mybesttools/Rowing_Display/assets/background-option-2.jpeg

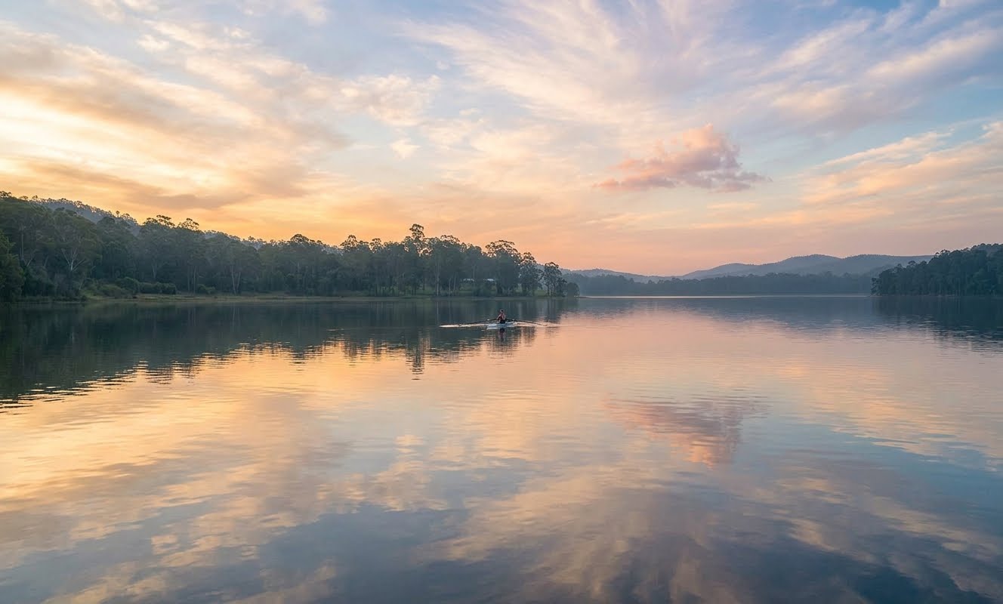
assets/background-option-2.jpeg
