mybesttools/Rowing_Display/assets/background-option-3.jpeg

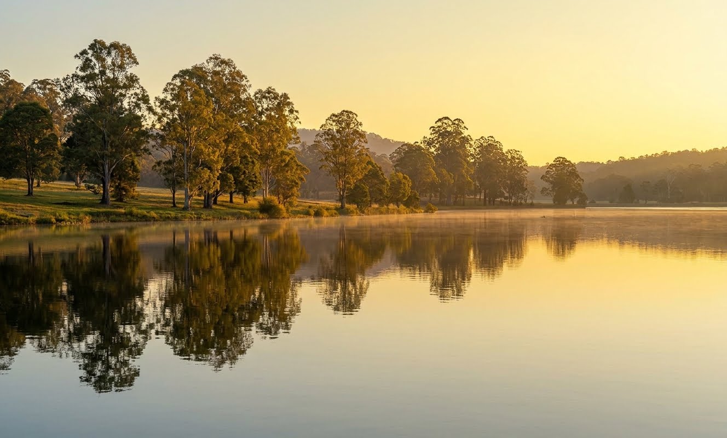
assets/background-option-3.jpeg
