mybesttools/Rowing_Display/assets/background-option-4.jpeg

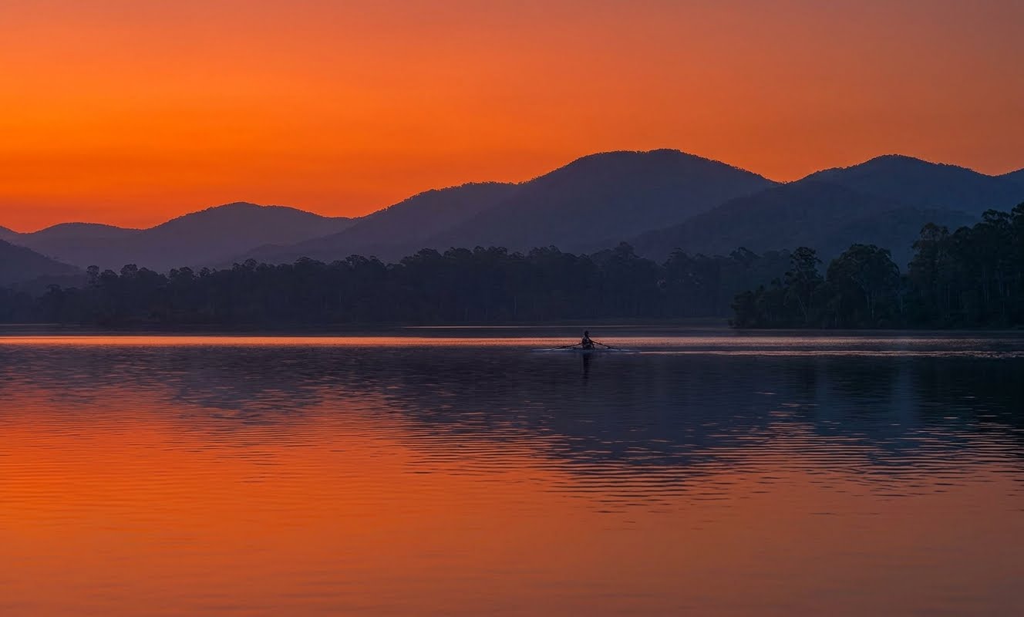
assets/background-option-4.jpeg
