mybesttools/Rowing_Display/assets/background-option-5.jpeg

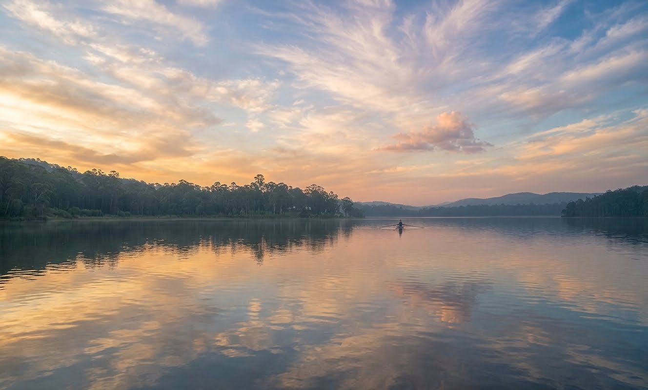
assets/background-option-5.jpeg
