mybesttools/Rowing_Display/assets/background-option-6.jpeg

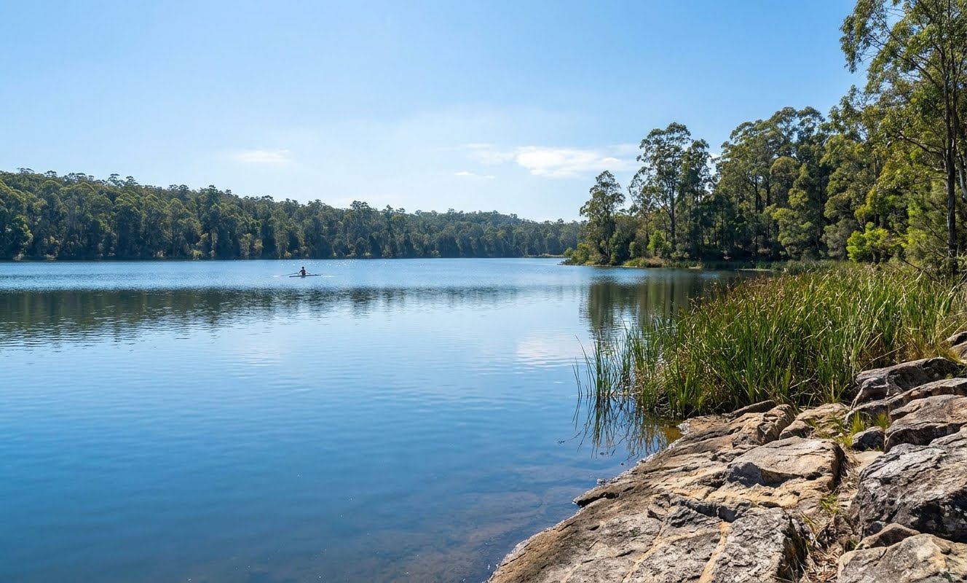
assets/background-option-6.jpeg
