mybesttools/Rowing_Display/assets/background-option-7.jpeg

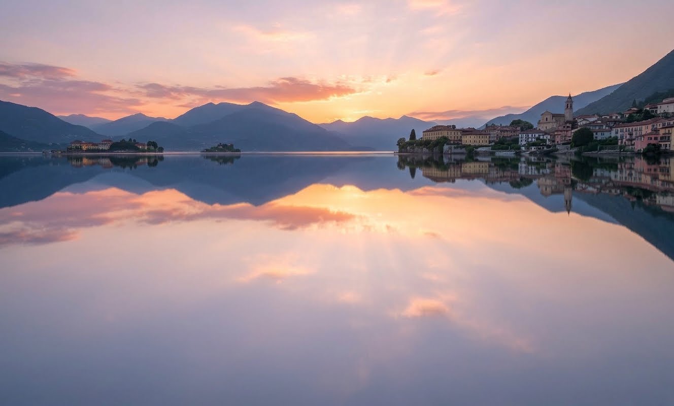
assets/background-option-7.jpeg
