mybesttools/Rowing_Display/assets/background-option-8.jpeg

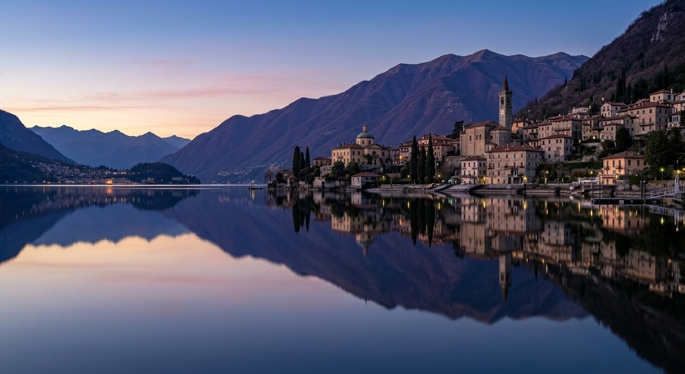
assets/background-option-8.jpeg
