mybesttools/Rowing_Display/assets/esp32-s3-touch-lcd-5-4_2.jpg

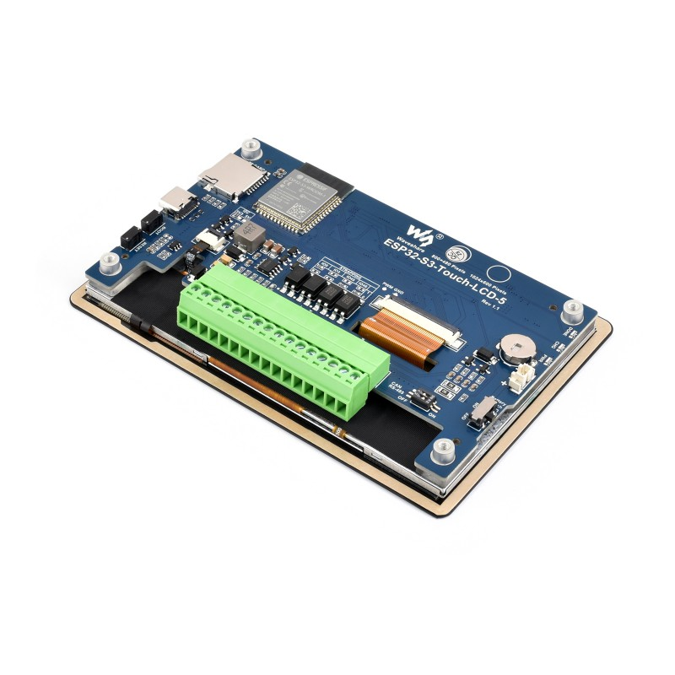
assets/esp32-s3-touch-lcd-5-4_2.jpg
