mybesttools/Rowing_Display/assets/scene_background.jpg

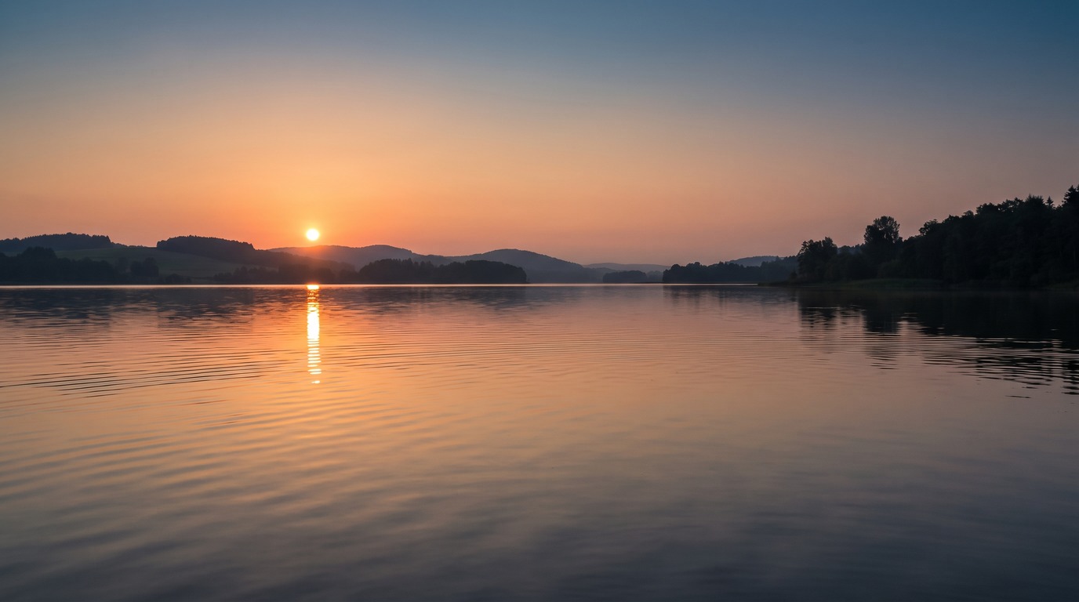
assets/scene_background.jpg
