mybesttools/Rowing_Display/docs/5-inch-device-display.jpeg

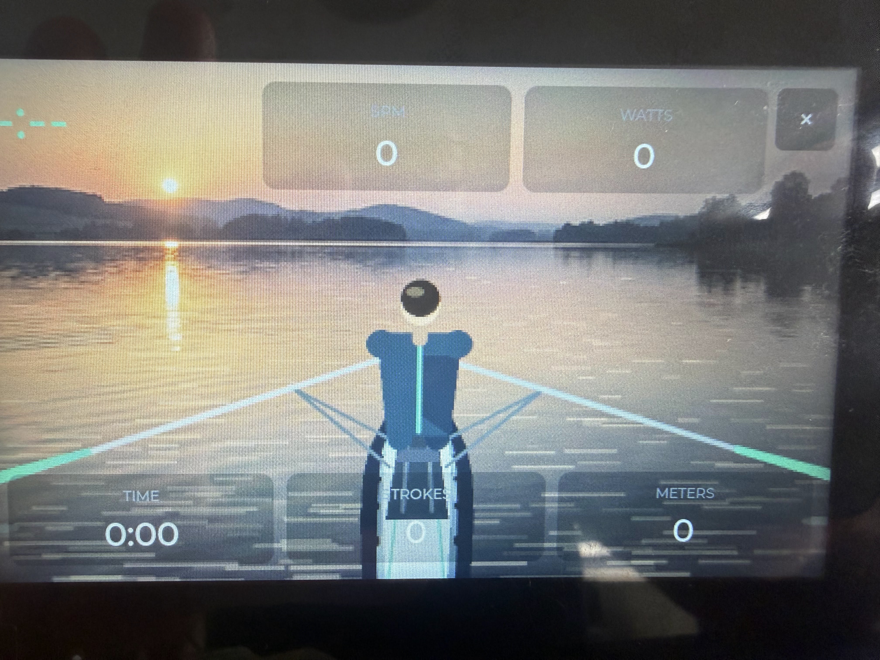
docs/5-inch-device-display.jpeg
