mybesttools/Rowing_Display/docs/blog/higgsfield-background/candidate-c-flux-2.jpg

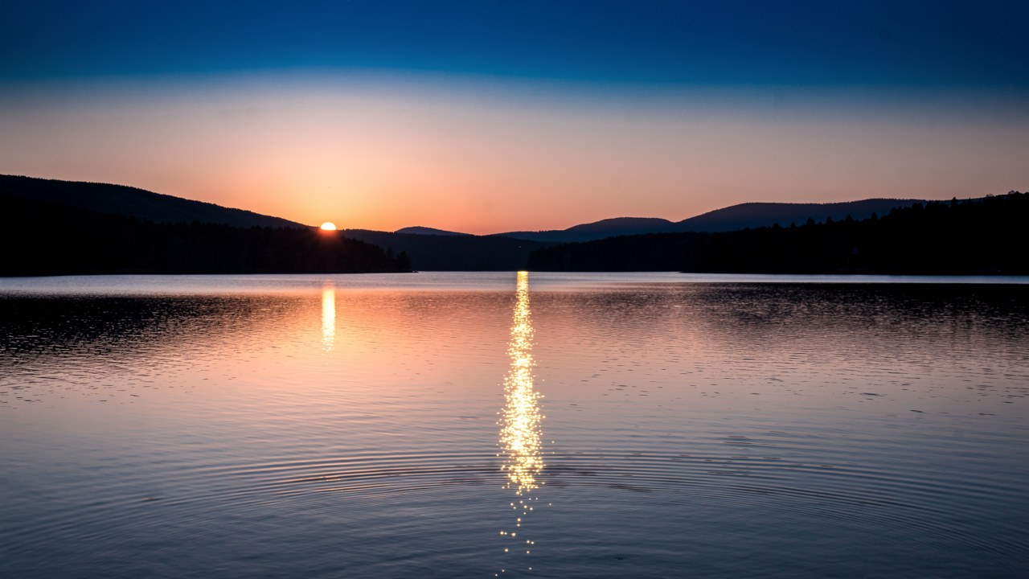
docs/blog/higgsfield-background/candidate-c-flux-2.jpg
