mybesttools/Rowing_Display/docs/blog/higgsfield-background/candidates-on-panel.png

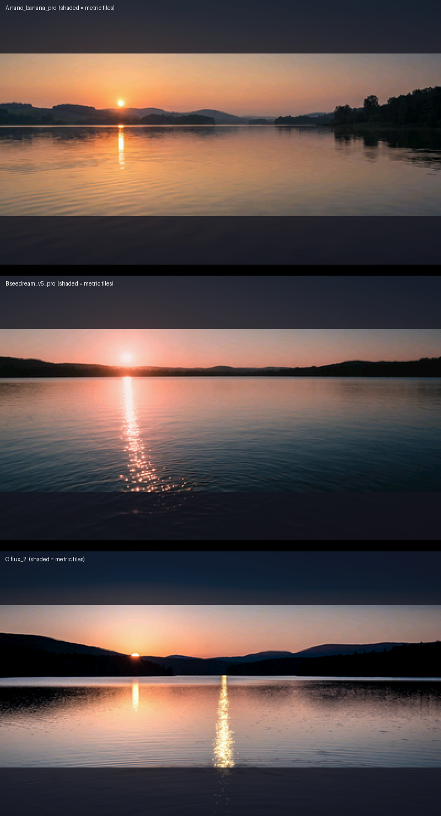
docs/blog/higgsfield-background/candidates-on-panel.png
