mybesttools/Rowing_Display/docs/board.jpg

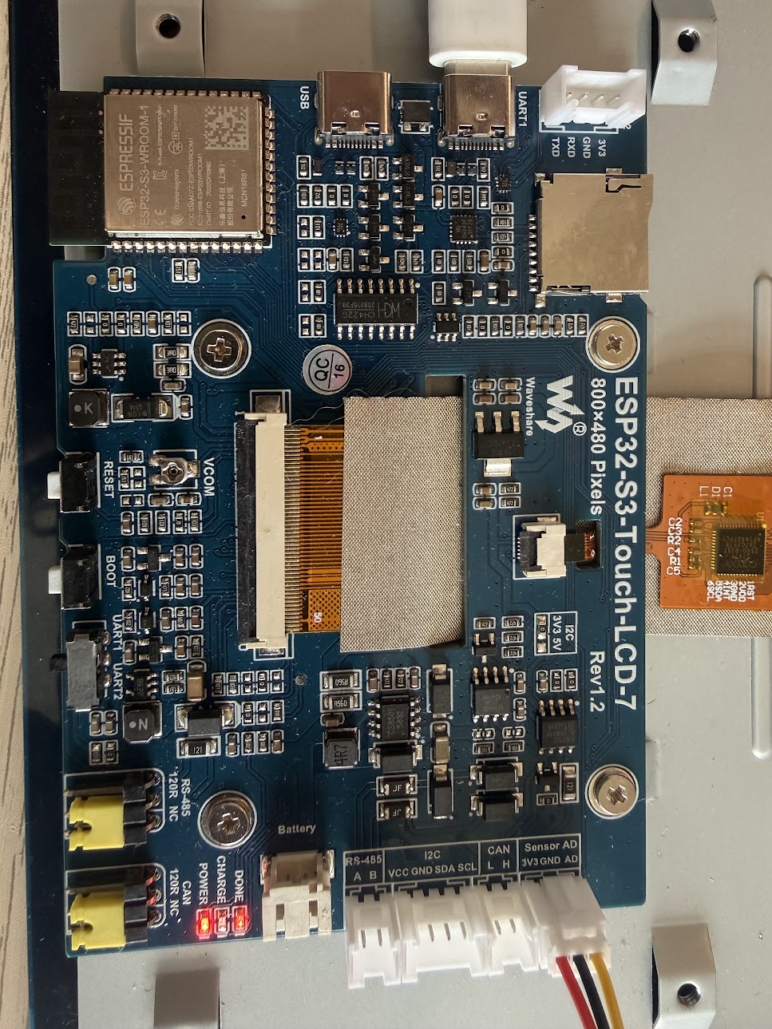
docs/board.jpg
