mybesttools/Rowing_Display/docs/ESP32-S3-Touch-LCD-5.jpeg

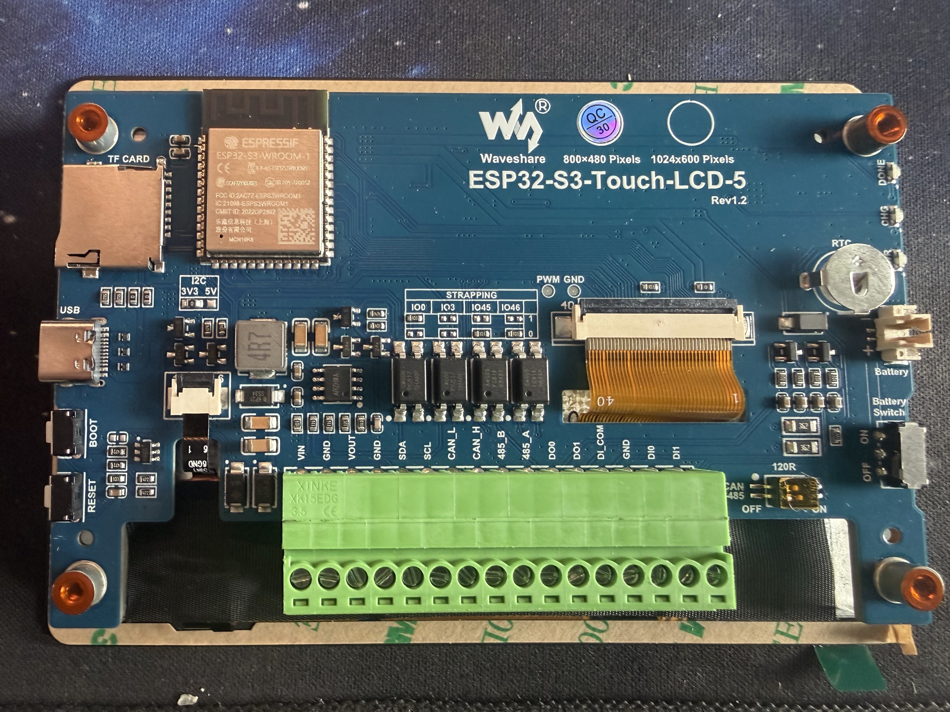
docs/ESP32-S3-Touch-LCD-5.jpeg
