mybesttools/Rowing_Display/hardware/Screen-01.png

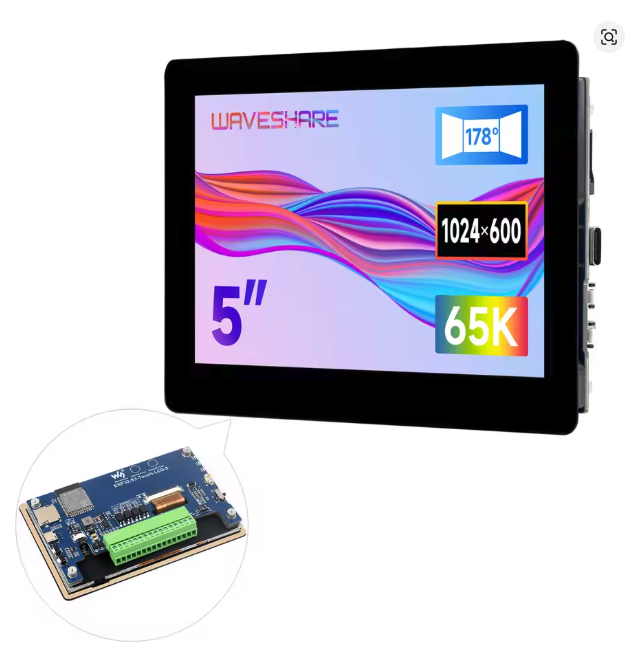
hardware/Screen-01.png
