mybesttools/Rowing_Display/hardware/Screen-02.png

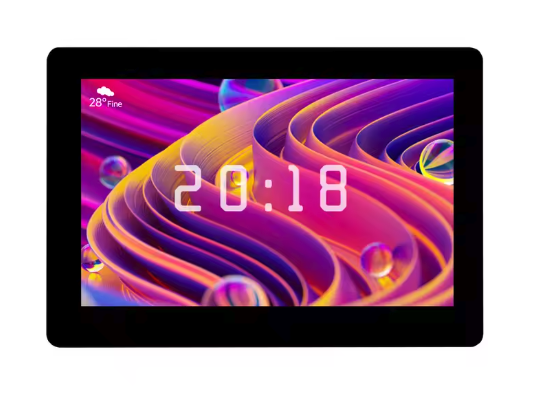
hardware/Screen-02.png
