mybesttools/Rowing_Display/hardware/Screen-03.png

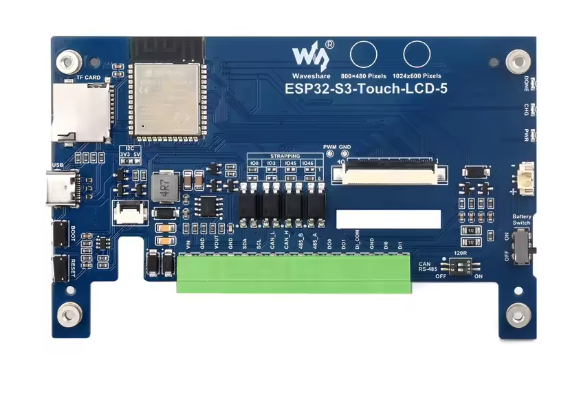
hardware/Screen-03.png
