mybesttools/Rowing_Display/3d_models/5Inch_Model_Case.stl

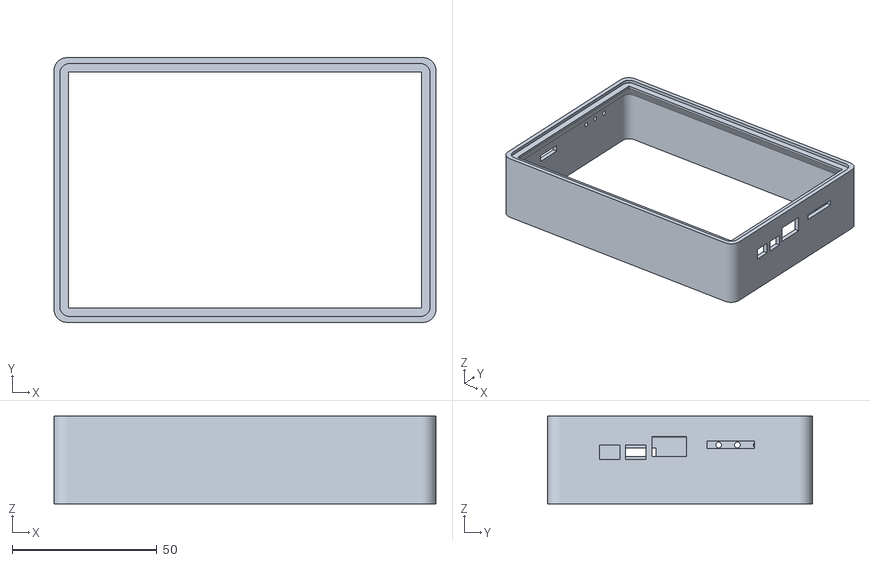
[picture p23: CAD file, 2026-10-24]
3d_models/5Inch_Model_Case.stl
132.0 x 91.5 x 30.4
