mybesttools/Rowing_Display/3d_models/7Inch_Model_Case.stl

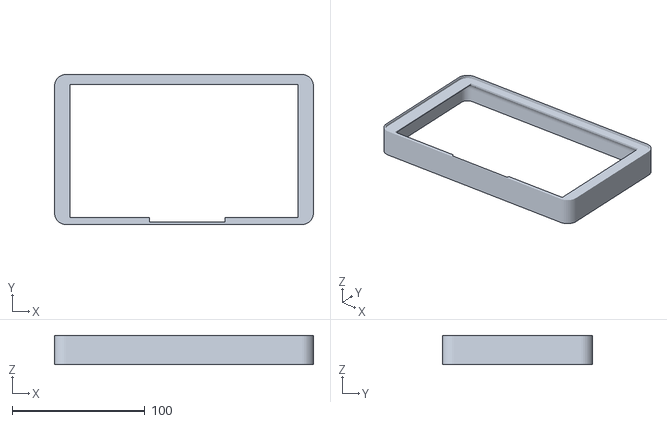
[picture p24: CAD file, 2026-10-23]
3d_models/7Inch_Model_Case.stl
194.9 x 113.0 x 22.0
