mybesttools/Rowing_Display/3d_models/7Inch_Backplate.stl

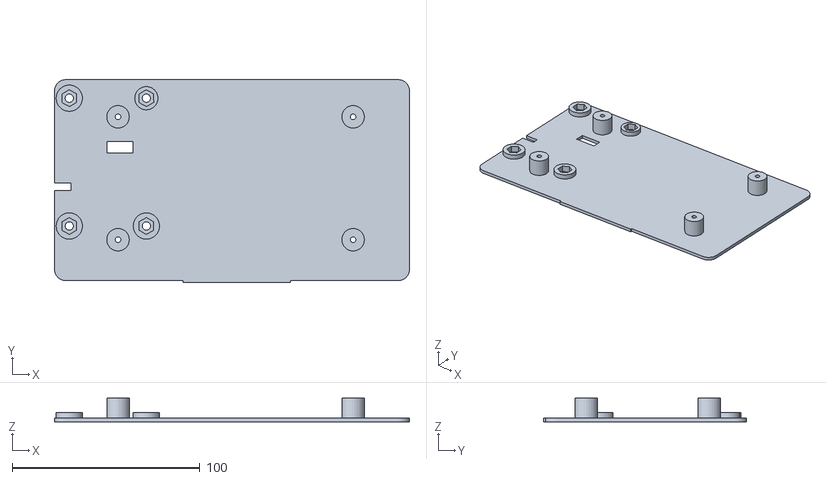
[picture p25: CAD file, 2026-10-23]
3d_models/7Inch_Backplate.stl
188.9 x 107.9 x 12.6
