mybesttools/Rowing_Display/3d_models/5Inch_Model_Slider_Inside.stl

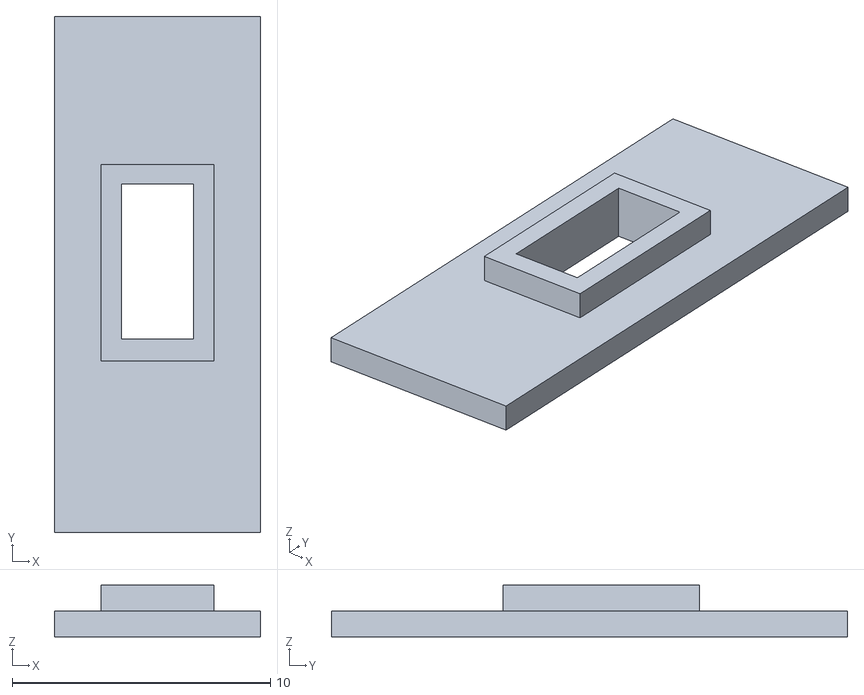
[picture p26: CAD file, 2026-10-21]
3d_models/5Inch_Model_Slider_Inside.stl
8.00 x 20.0 x 2.00
