mybesttools/Rowing_Display/3d_models/5Inch_Model_Slider.stl

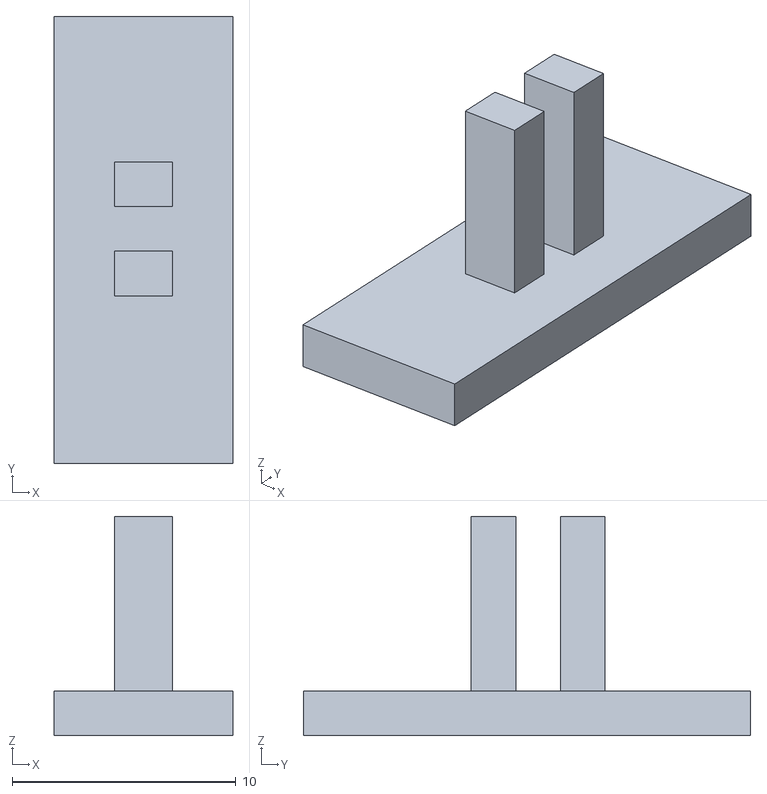
[picture p27: CAD file, 2026-10-21]
3d_models/5Inch_Model_Slider.stl
8.00 x 20.0 x 9.80
