mybesttools/Rowing_Display/3d_models/5Inch_Model.3mf

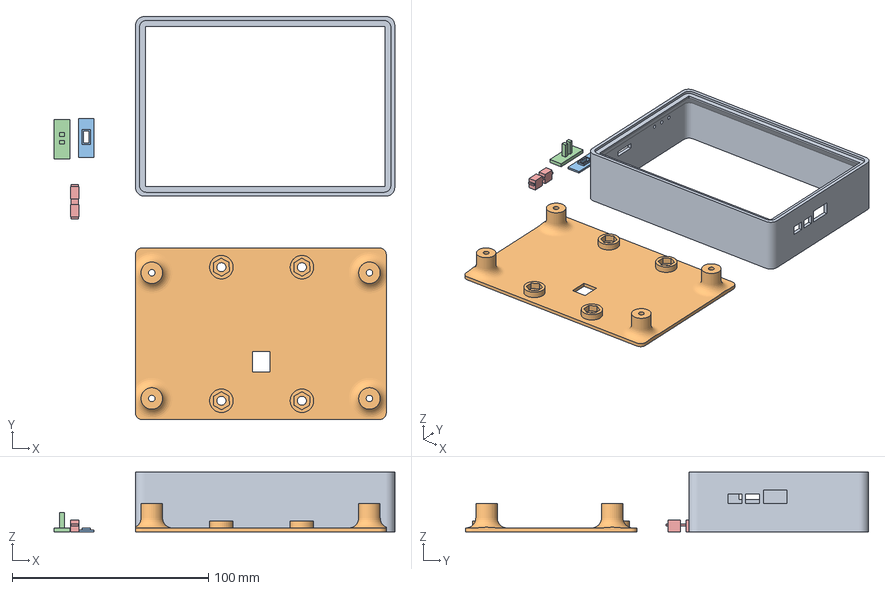
[picture p28: CAD file, 2026-10-21]
3d_models/5Inch_Model.3mf
173.4 x 205.2 x 30.4 mm
5Inch_Model_Case.stl
5Inch_Backplate.stl
5Inch_Model_Slider_Inside.stl
5Inch_Model_Slider.stl
5Inch_Double_Push_Button.stl
