mybesttools/Rowing_Display/3d_models/5Inch_Double_Push_Button.stl

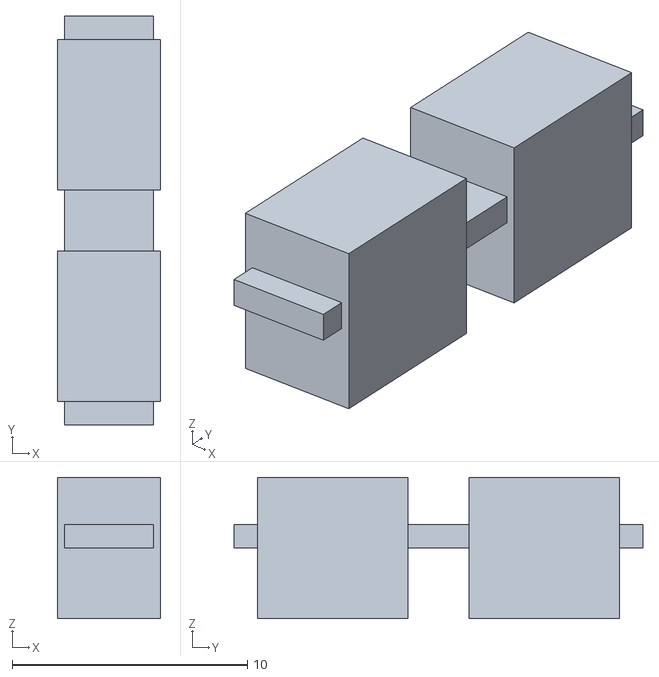
[picture p29: CAD file, 2026-10-21]
3d_models/5Inch_Double_Push_Button.stl
4.40 x 17.4 x 6.00
