mybesttools/Rowing_Display/3d_models/5Inch_Backplate.stl

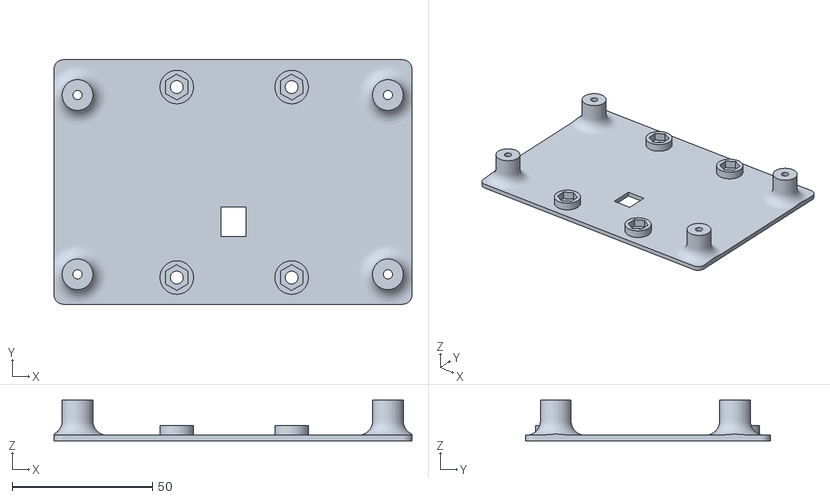
[picture p30: CAD file, 2026-10-21]
3d_models/5Inch_Backplate.stl
127.8 x 87.3 x 14.5
