mybesttools/Rowing_Display/firmware/src/sensor_input.h

#pragma once

#include <cstdint>

// Abstracts the stroke/rev sensor edge source, which differs by board — see
// the "Sensor input source" comment in config.h for the 7"-vs-5" rationale.
namespace sensor_input {

void begin();

// Debounce window and (5" board) which CH422G pin to read. Safe to call any
// time; the polling task/ISR picks the new values up on its next edge.
void configure(uint8_t expanderPin, uint16_t debounceMs);

// Call every loop(). A no-op on the 7"/devkit board (ISR-driven); on the 5"
// board it starts the core-0 polling task once the expander exists.
void poll(uint32_t nowMs);

// True once per detected pulse; call until false (the 5" board queues them).
// outPulseMicros is the pulse timestamp in the same units as micros() — synthesized from millis()
// on the polled (5" board) path, since that path can't resolve true
// microsecond edges and callers (PulseMode::Stroke) don't need them to.
bool consumePulse(uint32_t& outPulseMicros);

// Poll-coverage counters since the last call (5" board only; zeros elsewhere).
struct PollStats {
    uint32_t reads;
    uint32_t lockFails;
    uint32_t i2cFails;
    uint32_t maxGapMs; // longest stretch between two successful reads
};
PollStats takePollStats();

// 5" board: the CH422G is in input mode while DI polling runs, which leaves
// its other pins (the SD card's chip select) undriven. takeExpanderForOutput()
// pauses polling and puts it in output mode (DI latches low, so the inputs'
// pull-ups see no drive fight); releaseExpander() switches back and resumes.
// Pulses in between are missed. True / no-op on other boards, and before
// polling has started (the expander is still in output mode then).
bool takeExpanderForOutput();
void releaseExpander();

} // namespace sensor_input
