mybesttools/Rowing_Display/firmware/src/net_time.cpp

#include "net_time.h"

#include <Arduino.h>
#include <WiFi.h>

#include <cstdio>
#include <cstring>
#include <ctime>

#include "esp_heap_caps.h"
#include "esp_netif.h"
#include "esp_sntp.h"
#include "panel_runtime.h"
#include "rtc_clock.h"

namespace net_time {

namespace {

// Association plus DHCP.
constexpr uint32_t kConnectTimeoutMs = 30000;
// Joined but no DHCP answer after this long: drop the connection and ask
// again. A stalled DHCP exchange sometimes never recovers on its own (seen
// on the first syncs after the radio had been off for a while).
constexpr uint32_t kDhcpRetryMs = 8000;
// While the radio is on, Wi-Fi buffers in PSRAM compete with the RGB
// panel's frame DMA and the picture can shift; re-align it this often.
constexpr uint32_t kResyncEveryMs = 500;
constexpr uint32_t kSyncTimeoutMs = 10000;

struct Network {
    char name[33];
    int rssi;
};

volatile State g_state = State::Idle;
char g_status[48] = "";
Network g_networks[kMaxNetworks];
int g_networkCount = 0;

struct Job {
    bool scan;
    char ssid[33];
    char password[65];
    char tz[48];
};
Job g_job;

void setStatus(State s, const char* text) {
    snprintf(g_status, sizeof(g_status), "%s", text);
    g_state = s;
    printf("wifi: %s\n", text);
}

void radioOff() {
    WiFi.disconnect(true);
    WiFi.mode(WIFI_OFF);
    // Wi-Fi start-up can write PHY calibration to NVS: a flash write, which
    // shifts the RGB panel's frame (panel_runtime::resyncDisplay()).
    panel_runtime::resyncDisplay();
}

// delay() that keeps re-aligning the RGB panel while the radio is on.
void waitMs(uint32_t ms) {
    static uint32_t lastResync = 0;
    const uint32_t end = millis() + ms;
    while (static_cast<int32_t>(end - millis()) > 0) {
        delay(20);
        if (millis() - lastResync >= kResyncEveryMs) {
            lastResync = millis();
            panel_runtime::resyncDisplay();
        }
    }
}

void logDhcp() {
    esp_netif_t* netif = esp_netif_get_handle_from_ifkey("WIFI_STA_DEF");
    esp_netif_dhcp_status_t st = ESP_NETIF_DHCP_INIT;
    if (netif == nullptr || esp_netif_dhcpc_get_status(netif, &st) != ESP_OK) {
        printf("wifi: no STA netif\n");
        return;
    }
    esp_netif_ip_info_t ip{};
    esp_netif_get_ip_info(netif, &ip);
    printf("wifi: dhcp client %d (0 init, 1 started, 2 stopped), ip " IPSTR "\n", static_cast<int>(st), IP2STR(&ip.ip));
}

void scan() {
    WiFi.mode(WIFI_STA);
    WiFi.scanNetworks(true); // async, so the panel can be re-aligned meanwhile
    int n = WIFI_SCAN_RUNNING;
    for (int i = 0; i < 300 && n == WIFI_SCAN_RUNNING; i++) {
        waitMs(50);
        n = WiFi.scanComplete();
    }
    g_networkCount = 0;
    for (int i = 0; i < n; i++) {
        const String name = WiFi.SSID(i);
        if (name.length() == 0 || name.length() >= sizeof(Network::name)) {
            continue;
        }
        int found = -1;
        for (int j = 0; j < g_networkCount; j++) {
            if (strcmp(g_networks[j].name, name.c_str()) == 0) {
                found = j;
            }
        }
        if (found >= 0) {
            g_networks[found].rssi = max(g_networks[found].rssi, static_cast<int>(WiFi.RSSI(i)));
        } else if (g_networkCount < kMaxNetworks) {
            snprintf(g_networks[g_networkCount].name, sizeof(Network::name), "%s", name.c_str());
            g_networks[g_networkCount].rssi = WiFi.RSSI(i);
            g_networkCount++;
        }
    }
    WiFi.scanDelete();
    // Strongest first.
    for (int i = 1; i < g_networkCount; i++) {
        for (int j = i; j > 0 && g_networks[j].rssi > g_networks[j - 1].rssi; j--) {
            const Network t = g_networks[j];
            g_networks[j] = g_networks[j - 1];
            g_networks[j - 1] = t;
        }
    }
    radioOff();
    for (int i = 0; i < g_networkCount; i++) {
        printf("wifi:   %s (%d dBm)\n", g_networks[i].name, g_networks[i].rssi);
    }
    char text[48];
    if (n < 0) {
        snprintf(text, sizeof(text), "scan failed");
    } else {
        snprintf(text, sizeof(text), "%d networks found", g_networkCount);
    }
    setStatus(State::ScanDone, text);
}

// Last disconnect reason (wifi_err_reason_t) seen while connecting.
volatile int g_disconnectReason = 0;
volatile bool g_associated = false;

void onWifiEvent(arduino_event_id_t event, arduino_event_info_t info) {
    if (event == ARDUINO_EVENT_WIFI_STA_CONNECTED) {
        g_associated = true;
    }
    if (event == ARDUINO_EVENT_WIFI_STA_DISCONNECTED) {
        g_disconnectReason = info.wifi_sta_disconnected.reason;
        printf("wifi: disconnected, reason %d\n", g_disconnectReason);
    }
}

void sync() {
    static bool eventsHooked = false;
    if (!eventsHooked) {
        WiFi.onEvent(onWifiEvent);
        eventsHooked = true;
    }
    g_disconnectReason = 0;
    g_associated = false;
    printf("wifi: connecting to \"%s\" (password %u characters)\n", g_job.ssid,
           static_cast<unsigned>(strlen(g_job.password)));
    WiFi.mode(WIFI_STA);
    // No modem sleep: with BLE sharing the radio, the DHCP offer was missed
    // in about half the attempts. The radio is only on for seconds anyway.
    WiFi.setSleep(false);
    WiFi.begin(g_job.ssid, g_job.password);
    const uint32_t start = millis();
    uint32_t attemptStart = start;
    int attempt = 1;
    // A real address, not just WL_CONNECTED: right after a previous sync the
    // status can still read connected with 0.0.0.0.
    const auto connected = [] { return WiFi.status() == WL_CONNECTED && static_cast<uint32_t>(WiFi.localIP()) != 0; };
    while (!connected() && millis() - start < kConnectTimeoutMs) {
        waitMs(100);
        if (g_associated && millis() - attemptStart >= kDhcpRetryMs &&
            millis() - start + kDhcpRetryMs / 2 < kConnectTimeoutMs) {
            logDhcp();
            attempt++;
            printf("wifi: no IP address yet, reconnecting (attempt %d)\n", attempt);
            setStatus(State::Connecting, "no address yet, retrying...");
            g_associated = false;
            WiFi.disconnect();
            waitMs(300);
            WiFi.begin(g_job.ssid, g_job.password);
            attemptStart = millis();
        }
    }
    if (connected()) {
        printf("wifi: got %s after %lu ms (attempt %d)\n", WiFi.localIP().toString().c_str(),
               static_cast<unsigned long>(millis() - start), attempt);
    }
    if (!connected()) {
        const wl_status_t st = WiFi.status();
        const int reason = g_disconnectReason;
        radioOff();
        char text[48];
        if (g_associated) {
            // Joined (so the password is right) but DHCP never answered.
            snprintf(text, sizeof(text), "joined, but got no IP address");
        } else if (st == WL_NO_SSID_AVAIL || reason == WIFI_REASON_NO_AP_FOUND) {
            snprintf(text, sizeof(text), "network not found");
        } else if (reason == WIFI_REASON_AUTH_FAIL || reason == WIFI_REASON_4WAY_HANDSHAKE_TIMEOUT ||
                   reason == WIFI_REASON_HANDSHAKE_TIMEOUT) {
            snprintf(text, sizeof(text), "wrong password? (reason %d)", reason);
        } else {
            snprintf(text, sizeof(text), "can't connect (status %d, reason %d)", static_cast<int>(st), reason);
        }
        setStatus(State::Failed, text);
        return;
    }

    setStatus(State::Syncing, "getting the time...");
    // configTzTime, not configTime: the latter replaces TZ with a fixed offset.
    configTzTime(g_job.tz, "pool.ntp.org", "time.google.com", "time.cloudflare.com");
    // sntp_get_sync_status() reports COMPLETED once, then resets: read it once.
    const uint32_t syncStart = millis();
    bool ok = false;
    while (!ok && millis() - syncStart < kSyncTimeoutMs) {
        waitMs(100);
        ok = sntp_get_sync_status() == SNTP_SYNC_STATUS_COMPLETED;
    }
    esp_sntp_stop();
    radioOff();
    if (!ok) {
        setStatus(State::Failed, "no answer from time server");
        return;
    }
    rtc_clock::set(time(nullptr));
    const time_t now = time(nullptr);
    tm local{};
    localtime_r(&now, &local);
    char text[48];
    strftime(text, sizeof(text), "synced %H:%M", &local);
    setStatus(State::Synced, text);
}

void task(void*) {
    if (g_job.scan) {
        scan();
    } else {
        sync();
    }
    vTaskDelete(nullptr);
}

// Callers check busy() and set the state before calling this.
bool startJob() {
    WiFi.persistent(false); // credentials live in our settings, not Wi-Fi's own NVS
    // Core 0 with the sensor poll task, below its priority (5).
    if (xTaskCreatePinnedToCore(task, "net_time", 6144, nullptr, 2, nullptr, 0) == pdPASS) {
        return true;
    }
    printf("wifi: task create failed; internal heap free %u, largest block %u\n",
           static_cast<unsigned>(heap_caps_get_free_size(MALLOC_CAP_INTERNAL)),
           static_cast<unsigned>(heap_caps_get_largest_free_block(MALLOC_CAP_INTERNAL)));
    return false;
}

} // namespace

void startSync(const char* ssid, const char* password, const char* posixTz) {
    if (busy() || ssid == nullptr || ssid[0] == '\0') {
        return;
    }
    g_job.scan = false;
    snprintf(g_job.ssid, sizeof(g_job.ssid), "%s", ssid);
    snprintf(g_job.password, sizeof(g_job.password), "%s", password != nullptr ? password : "");
    snprintf(g_job.tz, sizeof(g_job.tz), "%s", posixTz);
    setStatus(State::Connecting, "connecting...");
    if (!startJob()) {
        setStatus(State::Failed, "couldn't start");
    }
}

void startScan() {
    if (busy()) {
        return;
    }
    g_job.scan = true;
    setStatus(State::Scanning, "scanning...");
    if (!startJob()) {
        setStatus(State::Failed, "couldn't start");
    }
}

volatile bool g_syncRequested = false;

void requestSync() {
    g_syncRequested = true;
}

bool takeSyncRequest() {
    const bool requested = g_syncRequested;
    g_syncRequested = false;
    return requested;
}

State state() {
    return g_state;
}

bool busy() {
    const State s = g_state;
    return s == State::Scanning || s == State::Connecting || s == State::Syncing;
}

const char* statusText() {
    return g_status;
}

int networkCount() {
    return g_state == State::Scanning ? 0 : g_networkCount;
}

const char* networkName(int i) {
    return i >= 0 && i < g_networkCount ? g_networks[i].name : "";
}

int networkRssi(int i) {
    return i >= 0 && i < g_networkCount ? g_networks[i].rssi : -100;
}

} // namespace net_time
