mybesttools/Rowing_Display/firmware/src/firmware_version.h

#pragma once

// "1.0.0" for a tagged release build, "1.0.0+<commit>[.dirty]" otherwise.
// Defined in firmware_version.cpp, generated at build time from VERSION by
// scripts/firmware_version.py.
extern const char kFirmwareVersion[];
