mybesttools/Rowing_Display/(commit log)

2026-09-24 Smoother rower scene, stroke-per-pulse mode, 5" board targets
    - rower_scene: render at 2x and downsample with dithering (anti-aliased
    edges, no RGB565 banding); fix inverted stroke kinematics; new dusk
    sky/hills, shimmering ripples, shaded hull. Static background cached,
    scratch canvas freed after precompute (boot render ~7.5 s).
    - PulseMode::Stroke (default): every pulse is one stroke; the animation
    replays drive/recovery from the last stroke interval. Flywheel physics
    kept as PulseMode::Revolution.
    - Debounce in a CHANGE ISR with a 15 ms quiet-before-press gate; drop the
    GPIO poll fallback that bypassed it (fixes double counts on release).
    - New esp32-s3-lcd5 / esp32-s3-lcd5-ku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
    [config.h, esp_panel_board_supported_conf.h, main.cpp, metrics_model.cpp, metrics_model.h, panel_runtime.cpp, rower_scene.cpp]
2026-10-02 Photo background for the rower scene (Higgsfield)
    - Sky and water are now a Higgsfield-generated dusk-lake image
    (assets/scene_background.jpg, Nano Banana Pro), baked by
    scripts/gen_scene_background.py into scene_background.{h,cpp}:
    400x240 RGB565, Floyd-Steinberg dithered, 192 KB flash.
    - rower_scene pixel-doubles it into the 2x canvas; camera horizon and
    sun-path glints follow the image, camY lowered so the rower keeps its
    screen position, ripples recoloured warm. Procedural sky/hills/water
    and the PSRAM background cache are removed. Boot render 6.5 s.
    - Escape button: keep it above the overlapping top bar and widen its
    touch area; metric rows no longer swallow taps.
    - docs/b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
    [gen_scene_background.py, panel_runtime.cpp, rower_scene.cpp]
2026-10-13 Verify 5" board scaffolding on real hardware, add pioarduino IDE recommendation
    The esp32-s3-lcd5 env (added in 5e9ea46, never hardware-tested) now has a
    real board: a Waveshare ESP32-S3-Touch-LCD-5, replacing one of the two
    broken 7" units. Built, flashed, and confirmed clean boot + running
    metrics loop on device. No firmware changes needed.
2026-10-13 5" board reed-switch input: poll CH422G DI0 instead of a raw GPIO ISR
    The 5" board (Waveshare ESP32-S3-Touch-LCD-5) has no equivalent to the 7"'s
    GPIO6 "Sensor AD" header — its DI0/DI1 terminals are read through the
    CH422G I2C IO expander, which also drives LCD reset, touch reset, backlight,
    and SD-CS. CH422G's 8 IO pins share one global direction bit, so DI0 can't
    go into a true input mode without breaking those; instead this relies on
    its quasi-bidirectional pins (leave the output latch at its power-on
    default, read the actual line state over I2C).
    New sensor_input.{h,cpp} abstracts the sensor edge source behind
    begin()/poll()/consumePulse(): unchanged GPIO6 CHANGE-ISR for the 7"/devkit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
    [config.h, main.cpp, panel_runtime.cpp, panel_runtime.h, sensor_input.cpp, sensor_input.h]
2026-10-13 Add 5" board reference doc to match the existing 7" one
    Pin mapping and CH422G IO-expander details (LCD reset/backlight/touch
    reset/SD-CS/DI0/DI1 multiplexing) for Waveshare ESP32-S3-Touch-LCD-5,
    mirroring docs/waveshare-esp32-s3-touch-lcd-7-reference.md.
2026-10-13 Dark blue tile text; document that battery level can't be read in firmware
    Tile caption/value colors (panel_runtime.cpp) changed from near-white/grey
    to dark blue for readability against the bright photo background showing
    through at low tile opacity. Flashed and verified on device.
    Checked both boards' schematics for a way to read battery charge/voltage:
    neither exposes one to the MCU. Both use a CS8501 charger IC whose CHRG/
    STDBY/DONE status pins drive LEDs directly with no GPIO fan-out; the 7"
    board has an unpopulated test-point voltage divider off VBAT, the 5" board
    doesn't even have that. Documented in Hardware.md along with the two real
    options if this is worth a hardware modificatio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
    [panel_runtime.cpp]
2026-10-13 Revert tile text to white
    Dark blue landed on the value numbers too, not just captions; user asked
    for plain white instead. Flashed and verified.
    [panel_runtime.cpp]
2026-10-15 Working reed input on the 5" board, Kuipers calibration, on-device settings
    The 5" board's DI input never registered a pulse. Per Waveshare's
    05_IO_Test and schematic: the CH422G only reports real pin levels in input
    mode (we read back the output latch), the reed must go DIx-GND (DIx-DI_COM
    shorts the PC814 opto LED), and DI reads collided with GT911 touch on the
    shared I2C bus. Polling now runs in its own core-0 task with an I2C-only
    lock, since LVGL renders for ~280 ms per frame on core 1 and starved it.
    An on-device pulse log (spare flash partition, scripts/fetch_pulse_log.py)
    made the rest diagnosable: the model was ticked with a clock older than
    queued pulses (strokes dropped to Idle),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
    [config.h, esp_lv_adapter_arduino.cpp, esp_lv_adapter_arduino.h, fetch_pulse_log.py, machine_presets.h, main.cpp, metrics_model.cpp, metrics_model.h]
2026-10-21 Blog post, 3D-printed case, hardware photos; stop tracking scratchpad
    - docs/blog/building-a-rowing-display.md + images: build write-up (hardware,
    BOM, scene, reed-input fixes, calibration, FTMS, roadmap)
    - 3d_models/: 5" case, backplate, on/off slider and button STLs + 3MF
    - hardware/: install/in-use photos, case render, reed pigtail
    - README/Hardware.md: both boards take a LiPo; 5" has an RTC coin cell
    - scratchpad/ is now gitignored and untracked (files stay on disk)
    [5Inch_Backplate.stl, 5Inch_Double_Push_Button.stl, 5Inch_Model.3mf, 5Inch_Model_Case.stl, 5Inch_Model_Slider.stl, 5Inch_Model_Slider_Inside.stl]
2026-10-23 Session averages, calories, FTMS control, TCX files on SD, pace boat
    - MetricsModel: session average pace and stroke rate, Concept2 calorie
    estimate, pause/resume (elapsed time skips the pause). Shown as an avg
    line under the split and a KCAL tile.
    - FTMS: Rower Data split into two 12-byte notifications so it fits the
    default ATT MTU; real averages and expended energy. Control point
    Start/Stop/Pause/Reset now drive the session, and every change is
    reported on Fitness Machine Status.
    - Session files: one sample per second in PSRAM, written as TCX to
    /sessions on the SD card when the session ends. sd_card.cpp is the
    shared mount; on the 5" board it borrows the CH422G in output mo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
    [ble_ftms.cpp, ble_ftms.h, ftms_encoder.cpp, ftms_encoder.h, main.cpp, metrics_model.cpp, metrics_model.h, pace_boat.cpp]
2026-10-23 FTMS: advertise the device name, notify from the buffer
    The advertisement (flags, FTMS UUID, service data) has no room for the
    name, so scanners saw an unnamed device; it now goes in the scan
    response. Rower Data and status are sent with notify(buffer, length):
    setValue() then notify() twice in a row delivered one corrupted packet
    in ~200 during testing; 468/468 good after the change.
2026-10-23 Pace boat: on/off switch, 5 s split steps, lane in view
    Settings > WORKOUT now has a Pace boat switch and a Target split that
    steps 5 s per tap and is kept while the boat is off (NVS v4 appends
    paceBoatOn; v2/v3 blobs load as a prefix). The ghost's lane moves from
    4.5 m to 3 m: at 4.5 m it sat past the right edge of the picture until
    it was about 3 m ahead, so only its left oar showed.
2026-10-23 Pace boat: draw it 6 m ahead so level is in view
    The camera behind our stern can't see a boat truly level with ours (only
    its oar tips showed at 4.5 m and 3 m lanes). It's now drawn 6 m further
    ahead than it is, in a 2.5 m lane, so level means just past our bow.
    The label keeps the real gap. Confirmed on the display.
2026-10-23 Clock sync over Wi-Fi, time zone, settings menu
    - Settings > Clock & Wi-Fi: time zone list (POSIX TZ with DST rules) and
    a Wi-Fi network chosen from a scan with an on-screen keyboard. The
    clock syncs over NTP at boot, after the network changes and on SYNC;
    each job runs on its own task and turns Wi-Fi off again, since radio
    and flash activity disturb the RGB panel. Credentials and zone are in
    the settings blob (NVS v5, v4 loads as a prefix). Home screen clock;
    session files named in local time, TCX times stay UTC. The RTC is read
    with its own date maths since mktime() applies the zone.
    - Settings is now a menu of six tiles showing their current values; each
    page fits on the s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
2026-10-23 Wi-Fi clock sync: fix job start, SNTP check, screen shift
    - startJob() refused every scan/sync because callers had already set a
    busy state ("couldn't start").
    - sntp_get_sync_status() returns COMPLETED only once; it was read twice,
    so a successful sync was reported as "no answer from time server".
    - A joined-but-no-IP station was reported as a password problem; it now
    says so, and the connect timeout is 30 s.
    - The RGB panel is re-aligned every 500 ms while the radio is on, since
    Wi-Fi traffic shifted the picture. Scans run async for the same reason.
    - Serial Y runs a sync with the saved settings.
    Verified on the 5": joined in 3 s, IP 13 ms later, NTP in 0.4 s, radio
    off again afte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
    [main.cpp, net_time.cpp]
2026-10-23 Weekly clock sync, clock battery warning, reliable DHCP
    - Sync at boot only when the last clock set is a week old (or the clock
    isn't valid), plus an hourly check while running, never mid-session.
    The last-set time is kept in NVS.
    - Warn ("clock battery?") when the RTC lost its time after having been
    set: the only sign of a missing or empty coin cell, since its voltage
    isn't readable (schematic) and the PCF85063A has no battery flag.
    - WiFi.setSleep(false) for the sync: DHCP offers were missed in about
    half the attempts with BLE sharing the radio; 6/6 syncs in 2-6 s after.
    [main.cpp, net_time.cpp, panel_runtime.cpp, rtc_clock.cpp, rtc_clock.h, settings_screen.cpp]
2026-10-23 Hardware.md: weekly clock sync, battery detection, DHCP note
2026-10-23 Blog BOM: case screws and nuts, CR927 cell, microSD card
2026-10-23 Blog BOM: clock battery as a regular part
2026-10-23 Convert photos in the SD card's images folder to backgrounds at boot
    JPEGs in /images without a matching /backgrounds/<name>.bin are decoded
    with the ESP32-S3 ROM TJpgDec and converted with a C++ port of
    background_tools.py (waterline from the reflection or a _hNN file name
    suffix, sun column, crop, sky colours, Floyd-Steinberg). The port matches
    the Python reference on six photos: identical waterline and sun guesses,
    colours within 1/255, mean pixel difference about 3/255. PNG and
    progressive JPEG are skipped with a log line.
    [background_convert.cpp, background_convert.h, image_import.cpp, image_import.h, sd_backgrounds.cpp, test_main.cpp]
2026-10-23 Splash screen; clock sync before the display builds its screens
    Wi-Fi and the RGB panel's PSRAM traffic disturb each other, and the boot
    sync used to overlap the scene-frame rendering. The display now starts on
    a splash screen, the clock sync runs to the end first with its progress
    shown there, and only then are the backgrounds loaded and the frames
    rendered. Later syncs (weekly, SYNC button, new network) also run with
    the splash up and return to the previous screen. Serial F forgets the
    last sync for testing.
2026-10-23 Docs and case files: firmware README, 5" reference, 7" case
    - firmware/README.md rewritten as a source map; 5" board reference and
    root README brought up to date (DI1 wiring, SD, RTC, Hall sensor plan).
    - 7" case and backplate STLs added; 5" case updated.
    - Removed the unused cable test photo.
    [5Inch_Model_Case.stl, 7Inch_Backplate.stl, 7Inch_Model_Case.stl]
2026-10-24 5" case model update; screen images
    [5Inch_Model_Case.stl]
2026-10-27 Firmware versioning: VERSION, CHANGELOG, build stamp
    VERSION holds the release number (1.0.0) and CHANGELOG.md lists what
    changed. scripts/firmware_version.py stamps each build: the plain number
    on a clean build of tag v<VERSION>, otherwise +<sha> and .dirty for local
    changes. The version shows on the splash and home screens, in the boot log
    and as the BLE Device Information firmware revision. README has the
    release steps.
2026-10-28 Browser installer on GitHub Pages and release builds from tags
    A v* tag builds all four board/machine variants, attaches merged images
    to the GitHub release (notes from CHANGELOG) and publishes an ESP Web
    Tools installer page to GitHub Pages.
2026-10-28 Release workflow: build older tags with the current installer script
2026-10-28 Add 5" board photos and web installer screenshot
2026-10-29 Pulse log: no flash writes while rowing
    A forced flush 8.8 min into a session shifted the RGB frame and the
    resync after it did not bring it back. The log now only writes when
    rowing has stopped; past 32 KB it keeps pulses and session events only
    and counts what it drops in a D line.
